marangisto/Divider/transparent.png

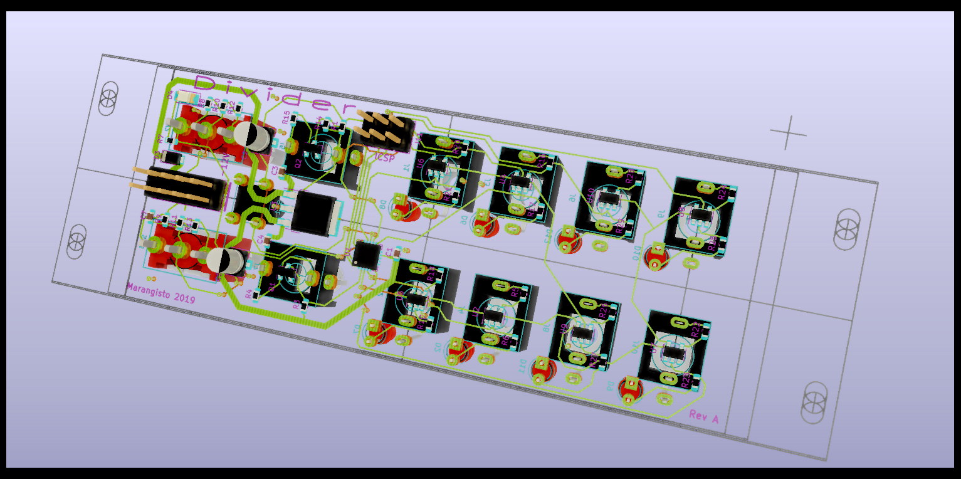
transparent.png
