marangisto/Divider/front.png

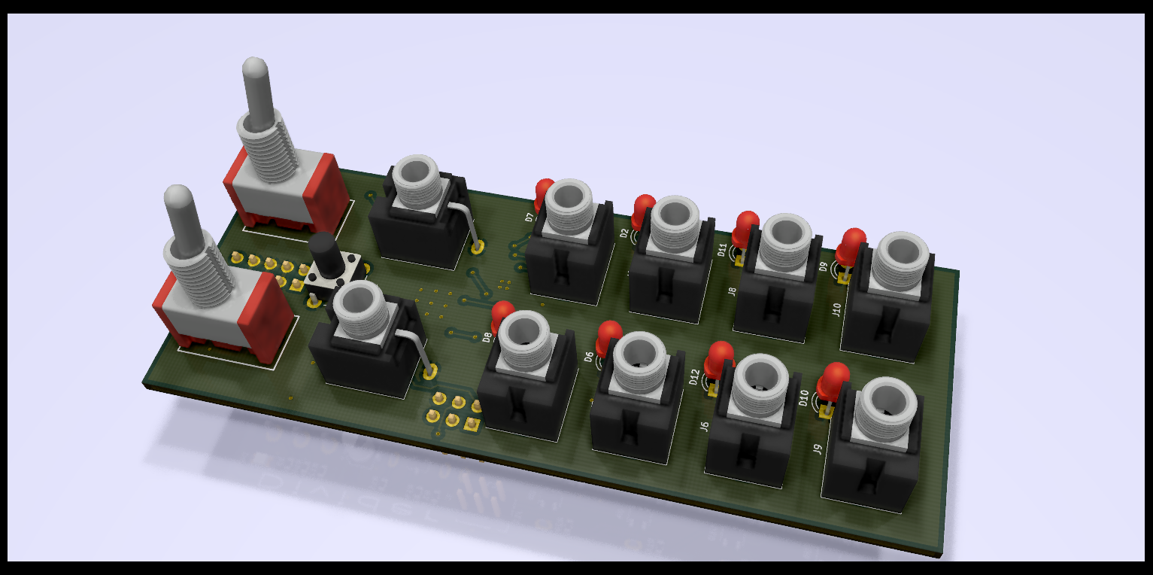
front.png
