marangisto/Divider/README.md

# Divider
Eurorack Modular Clock Divider
