marangisto/Divider/back.png

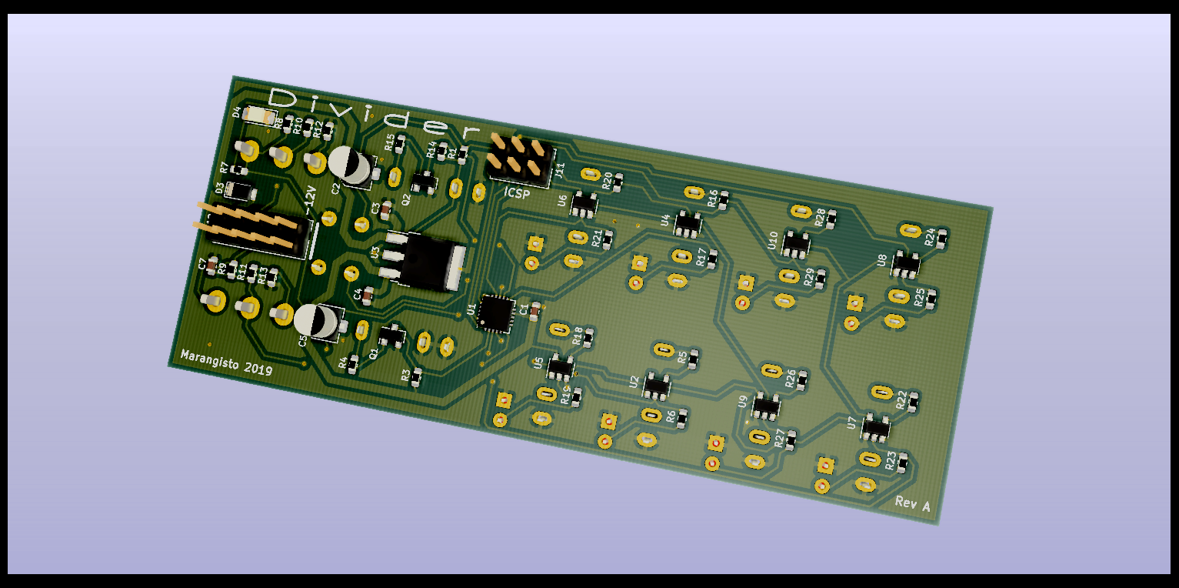
back.png
