marangisto/Divider/closeup.png

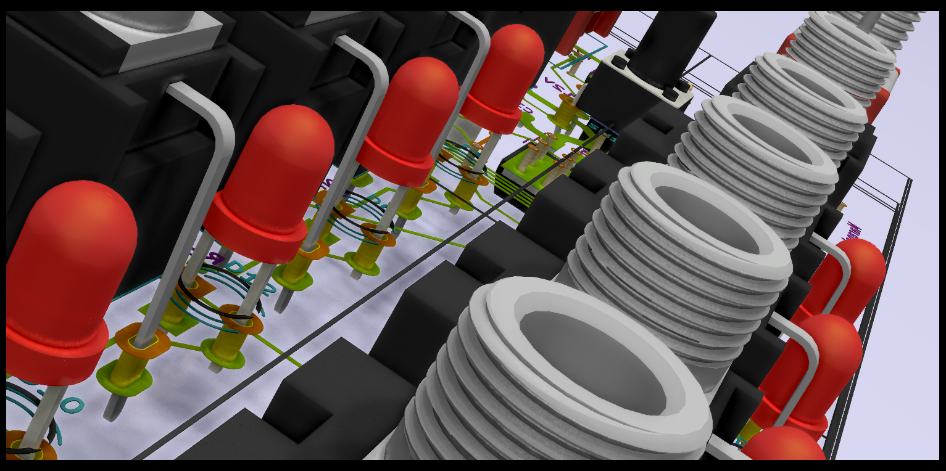
closeup.png
