marangisto/Divider/edgecuts.dxf

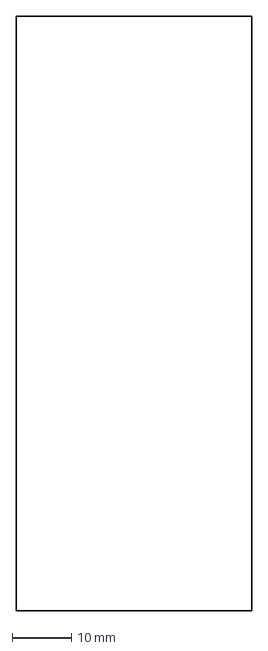
[picture p5: CAD file, 2019-01-02]
edgecuts.dxf
39.6 x 100.0 mm
