marangisto/Divider/drawing.dxf

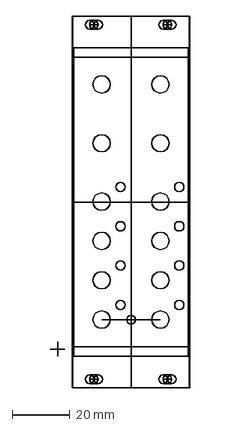
[picture p6: CAD file, 2019-01-02]
drawing.dxf
48.3 x 128.5 mm
