marangisto/Divider/Divider.kicad_pcb

## KiCad design Divider.kicad_pcb (2019-01-03)

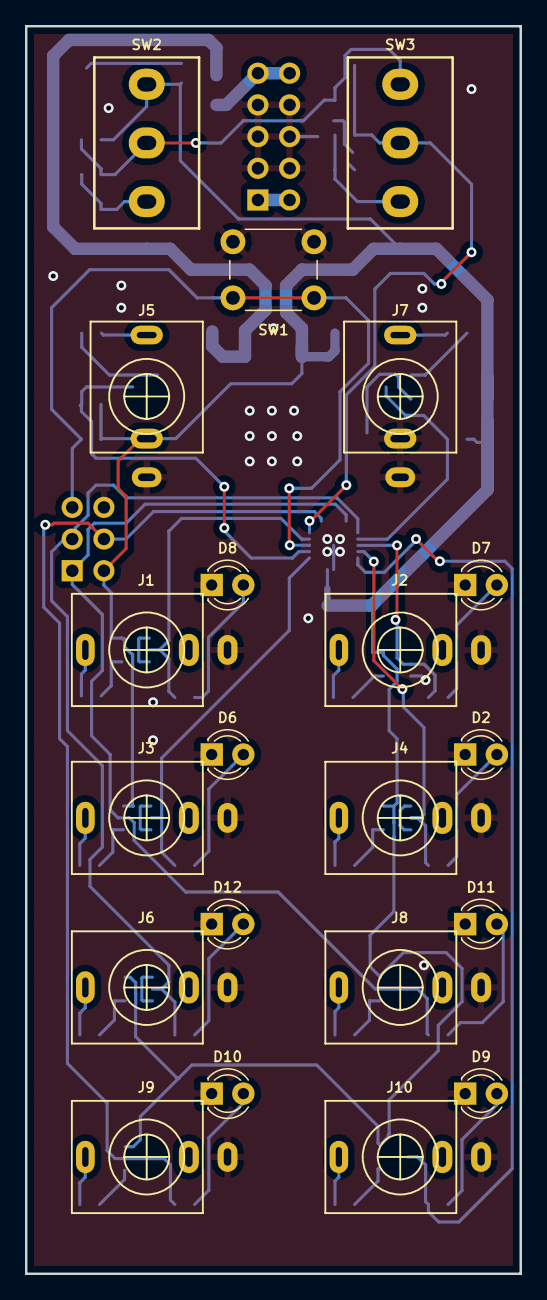
[picture p7: board Divider.kicad_pcb from above]

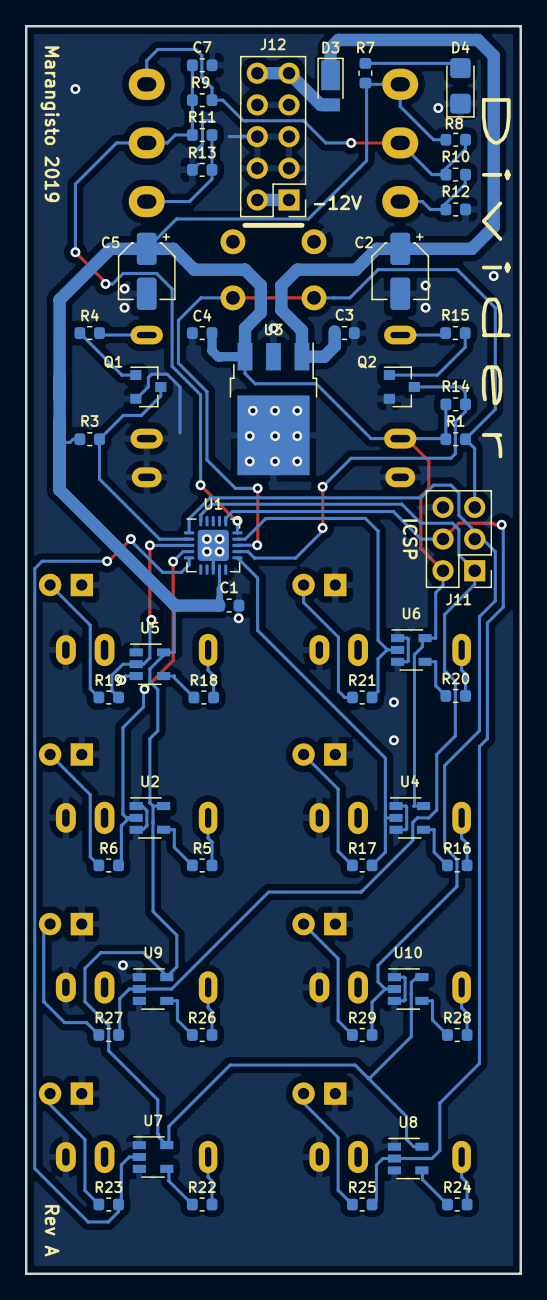
[picture p8: board Divider.kicad_pcb from below]

Board: 2 copper layers, 39.6 x 100.0 mm, 71 parts (50 on the bottom side), 49 nets.

Parts:
C1, C3, C4, C7: 100n; C_0603_1608Metric
C2, C5: 10u; CP_Elec_4x5.8
D2, D6, D7, D8, D9, D10, D11, D12: LED; LED_D3.0mm
D3: DFLR1400-7; D_PowerDI-123
D4: LED; LED_1206_3216Metric_Castellated
J1, J2, J3, J4, J5, J6, J7, J8, J9, J10: AudioJack2_SwitchT; PJ398SM
J11: Conn_02x03_Odd_Even; PinHeader_2x03_P2.54mm_Vertical
J12: Conn_02x05_Odd_Even; PinHeader_2x05_P2.54mm_Vertical
Q1, Q2: BC847; SOT-23
R1, R3, R14: 10k; R_0603_1608Metric
R4, R15: 100k; R_0603_1608Metric
R5, R16, R18, R20, R22, R24, R26, R28: 1k; R_0603_1608Metric
R6, R7, R17, R19, R21, R23, R25, R27, R29: 330; R_0603_1608Metric
R8: 4k7; R_0603_1608Metric
R9: 15k; R_0603_1608Metric
R10: 68k; R_0603_1608Metric
R11: 33k; R_0603_1608Metric
R12: 3k3; R_0603_1608Metric
R13: 22k; R_0603_1608Metric
SW1: SW_Push; SW_PUSH_6mm_H9.5mm
SW2, SW3: SW_SPDT_MSM; SPDT
U1: ATtiny84-20MU; QFN-20-1EP_4x4mm_P0.5mm_EP2.5x2.5mm
U2, U4, U5, U6, U7, U8, U9, U10: 74AHCT1G125; SOT-23-5
U3: L7805; TO-252-3_TabPin2

Connections:
+5V: C1.1, C4.1, C5.1, J5.TN, J11.2, R1.1, R3.1, R7.1, R8.1, R14.1, SW2.3, U1.9, U2.5, U3.3, U4.5, U5.5, U6.5, U7.5, U8.5, U9.5, U10.5
+12V: C2.1, C3.1, D3.1, U3.1
/DigitalIn/In: J7.T, R4.1
/DigitalOut/Out: J4.T, R5.1
/sheet5C2AB00C/In: J5.T, R15.1
/sheet5C2AE401/Out: J3.T, R16.1
/sheet5C2AEF1D/Out: J1.T, R20.1
/sheet5C2AEF07/Out: J2.T, R18.1
/sheet5C2AFDF5/Out: J10.T, R22.1
/sheet5C2AFE0B/Out: J9.T, R24.1
/sheet5C2AFE21/Out: J8.T, R26.1
/sheet5C2AFE37/Out: J6.T, R28.1
CLK: Q2.3, R14.2, U1.12
GND: C1.2, C2.2, C3.2, C4.2, C5.2, C7.2, D2.1, D4.1, D6.1, D7.1, D8.1, D9.1, D10.1, D11.1, D12.1, J1.S, J2.S, J3.S, J4.S, J5.S, J6.S, J7.S, J7.TN, J8.S, J9.S, J10.S, J11.6, J12.3, J12.4, J12.5, J12.6, J12.7, J12.8, Q1.2, Q2.2, R12.2, R13.2, SW1.2, U1.8, U1.21, U2.1, U2.3, U3.2, U4.1, U4.3, U5.1, U5.3, U6.1, U6.3, U7.1, U7.3, U8.1, U8.3, U9.1, U9.3, U10.1, U10.3
MISO: J11.1, R27.1, U1.20, U9.2
MOSI: J11.4, R25.1, U1.16, U8.2
unnamed: D2.2, R6.2
unnamed: D3.2, J12.9, J12.10
unnamed: D4.2, R7.2
unnamed: D6.2, R17.2
unnamed: D7.2, R19.2
unnamed: D8.2, R21.2
unnamed: D9.2, R23.2
unnamed: D10.2, R25.2
unnamed: D11.2, R27.2
unnamed: D12.2, R29.2
unnamed: J12.1, J12.2
unnamed: Q1.1, R4.2
unnamed: Q2.1, R15.2
unnamed: R5.2, U2.4
unnamed: R8.2, R9.1, R10.1, SW2.2, SW3.3
unnamed: R10.2, R12.1, SW2.1
unnamed: R11.2, R13.1, SW3.1
unnamed: R16.2, U4.4
unnamed: R18.2, U5.4
unnamed: R20.2, U6.4
unnamed: R22.2, U7.4
unnamed: R24.2, U8.4
unnamed: R26.2, U9.4
unnamed: R28.2, U10.4
OUT0: R21.1, U1.14, U6.2
OUT1: R19.1, U1.3, U5.2
OUT2: R17.1, U1.11, U4.2
OUT3: R6.1, U1.4, U2.2
OUT4: J11.3, R29.1, U1.1, U10.2
OUT7: R23.1, U1.5, U7.2
RESET: J11.5, R1.2, SW1.1, U1.13
RST: Q1.3, R3.2, U1.2
SPDTS: C7.1, R9.2, R11.1, SW3.2, U1.15
