marangisto/Divider/src/Main.cpp

#define NO_TIMER_VECTORS 1
#include <Main.h>
#include <Delay.h>
#include <Timer.h>
#include <ADC.h>
#include <Pins.h>

template <class T> const T& max(const T& a, const T& b) { return (a<b) ? b : a; }
template <class T> const T& min(const T& a, const T& b) { return (a<b) ? a : b; }

typedef outputs_t
    < output_t<PB, 2>
    , output_t<PB, 0>
    , output_t<PA, 4>
    , output_t<PA, 6>
    , output_t<PA, 2>
    , output_t<PA, 1>
    , output_t<PA, 5>
    , output_t<PA, 0>
    > output;

typedef input_t<PA, 3> in_rst;  // PCINT3
typedef input_t<PB, 1> in_clk;  // PCINT9

static const uint8_t spdts = 7;

static const uint8_t nchan = 8;

static const uint16_t arith[nchan] = { 2, 3, 4, 5, 6, 7, 8, 9 };
static const uint16_t prime[nchan] = { 2, 3, 5, 7, 11, 13, 17, 19 };
static const uint16_t power[nchan] = { 2, 4, 8, 16, 32, 64, 128, 256 };

static volatile const uint16_t *divs = arith;

static volatile bool do_reset = true;

enum mode_t { gate_mode, trig_mode, scan_mode };

static volatile mode_t mode = gate_mode;

ISR(PCINT0_vect)
{
    if (!in_rst::read())    // inverted input
        do_reset = true;
}

ISR(PCINT1_vect)
{
    static uint8_t bits = 0;
    static uint8_t counts[nchan];

    if (do_reset)
    {
        for (uint8_t i = 0; i < nchan; ++i)
            counts[i] = 0;

        bits = 0;
        do_reset = false;

        if (in_clk::read())     // N.B. discard falling edge (inverted input)
            return;
    }

    switch (mode)
    {
    case gate_mode:
        for (uint8_t i = 0; i < nchan; ++i)
        {
            if (counts[i] == 0)
                bits ^= _BV(i);
            if (++counts[i] == divs[i])
                counts[i] = 0;
        }
        break;
    case trig_mode:
        for (uint8_t i = 0; i < nchan; ++i)
        {
            if (counts[i] == 0)
                bits |= _BV(i);
            else
                bits &= ~_BV(i);
            if (++counts[i] == divs[i] << 1)
                counts[i] = 0;
        }
        break;
    case scan_mode:
        if (in_clk::read())
            return;         // discard trailing edges (inverted input)
        if (!(bits = bits << 1))
            bits = 1;
        break;
    }

    output::write(bits);
}

enum sw_pos_t { sw_err, sw_dn, sw_mid, sw_up };

static uint8_t read_spdts() // return sw0 | (sw1 << 2)
{
    static uint16_t midpoints[] = { 956, 846, 757, 659, 559, 459, 365, 281, 119 };

    uint16_t x = adc::read<spdts>();

    for (uint8_t i = 0; i < sizeof(midpoints) / sizeof(*midpoints); ++i)
        if (x > midpoints[i])
            switch (i)
            {
                case 0: return sw_dn | (sw_dn << 2);
                case 1: return sw_mid | (sw_dn << 2);
                case 2: return sw_dn | (sw_mid << 2);
                case 3: return sw_mid | (sw_mid << 2);
                case 4: return sw_dn | (sw_up << 2);
                case 5: return sw_mid | (sw_up << 2);
                case 6: return sw_up | (sw_dn << 2);
                case 7: return sw_up | (sw_mid << 2);
                case 8: return sw_up | (sw_up << 2);
            }

    return sw_err | (sw_err << 2);
}

void setup()
{
    output::setup();

    in_rst::setup();
    in_clk::setup();
    adc::setup<128>();

    PCMSK0 |= _BV(PCINT3);  // enable pin-change interrupt on rst (PCINT3)
    GIMSK |= _BV(PCIE0);    // enable channel 0 pin-change interrupts

    PCMSK1 |= _BV(PCINT9);  // enable pin-change interrupt on clk (PCINT9)
    GIMSK |= _BV(PCIE1);    // enable channel 1 pin-change interrupts

    sei();
}

void loop()
{
    static sw_pos_t sw0 = sw_err, sw1 = sw_err;
    uint8_t s = read_spdts();
    sw_pos_t _sw0 = static_cast<sw_pos_t>(s & 0x3);
    sw_pos_t _sw1 = static_cast<sw_pos_t>(s >> 2);

    if (_sw0 != sw0 || _sw1 != sw1)
    {
        sw0 = _sw0;
        sw1 = _sw1;

        switch (sw0)
        {
        case sw_dn:
            divs = prime;
            break;
        case sw_mid:
            divs = arith;
            break;
        case sw_up:
            divs = power;
            break;
        default: ;
        }

        switch (sw1)
        {
        case sw_dn:
            mode = gate_mode;
            break;
        case sw_mid:
            mode = trig_mode;
            break;
        case sw_up:
            mode = scan_mode;
            break;
        default: ;
        }

        do_reset = true;
    }
}
