marangisto/Divider/(commit log)

2018-12-31 Initial design.
    [DigitalIn.sch, DigitalOut.sch, Divider.kicad_pcb, Divider.sch, DualSW.sch, POW5V.sch]
2019-01-01 Initial placement.
    [Divider.kicad_pcb]
2019-01-01 Manual power routing.
    [DigitalIn.sch, DigitalOut.sch, Divider.kicad_pcb, Divider.sch, POW5V.sch]
2019-01-01 Complete signal routing.
    [Divider.kicad_pcb]
2019-01-01 Ground pours.
    [Divider.kicad_pcb]
2019-01-01 Improved pour.
    [Divider.kicad_pcb]
2019-01-02 Front silk-screen.
    [Divider.kicad_pcb]
2019-01-02 Back silk-screen.
    [Divider.kicad_pcb]
2019-01-02 Added Gerbers.
    [Divider-B.Cu.gbr, Divider-B.Mask.gbr, Divider-B.Paste.gbr, Divider-B.SilkS.gbr, Divider-Edge.Cuts.gbr, Divider-F.Cu.gbr, Divider-F.Mask.gbr, Divider-F.SilkS.gbr]
2019-01-02 Added drawings.
    [drawing.dxf, edgecuts.dxf]
2019-01-02 Updated pcb for Gerbers.
    [Divider.kicad_pcb]
2019-01-02 Added BOM.
    [Divider.csv]
2019-01-03 Removed accidental slot.
    [Divider-B.Cu.gbr, Divider-B.Mask.gbr, Divider-B.Paste.gbr, Divider-B.SilkS.gbr, Divider-Edge.Cuts.gbr, Divider-F.Cu.gbr, Divider-F.Mask.gbr, Divider-F.SilkS.gbr]
